ZeniteSolar/MT19/README.md

# MT19
Tachometer Module for CANBUS with ATmega328p
