ZeniteSolar/MT19/hardware/rj45.step

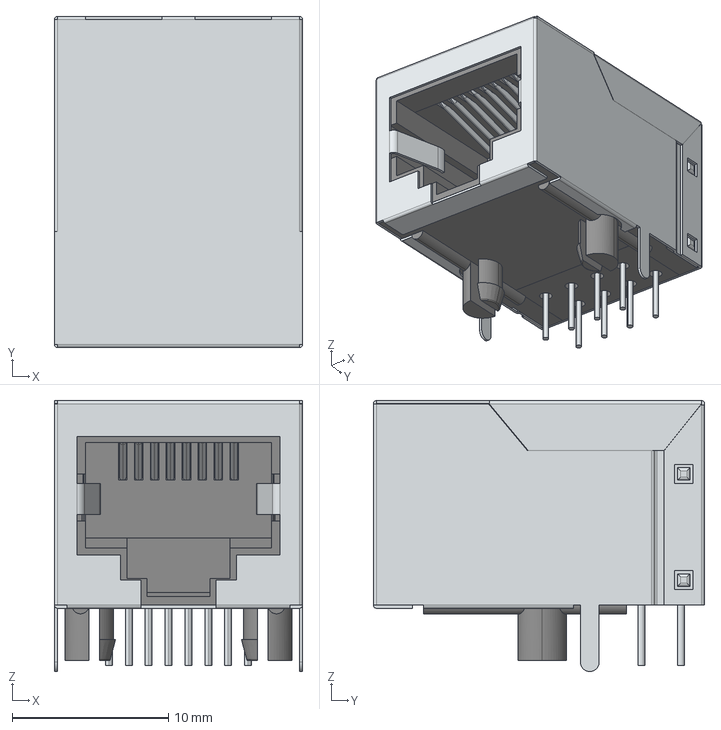
[picture p1: CAD file, 2019-05-07]
hardware/rj45.step
15.9 x 21.2 x 17.3 mm
