ZeniteSolar/MT19/hardware/PDF/basicsensormodule.pdf

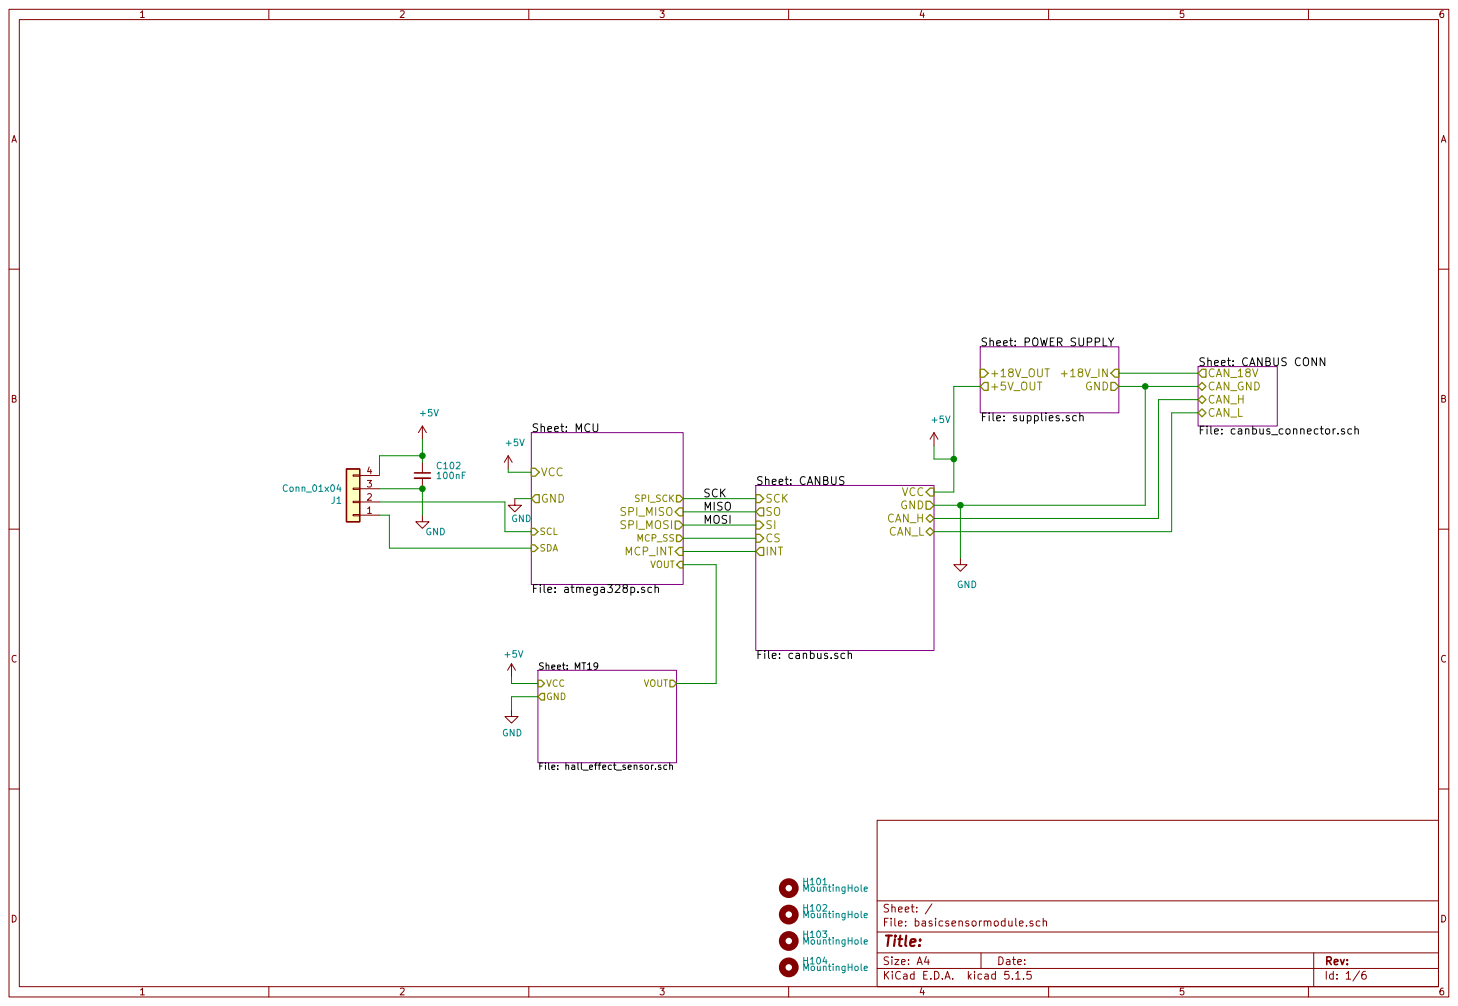
[picture p2: page 1]

Id: 1/6 Title: File: basicsensormodule.sch Sheet: / Sheet: MCU
+5VGND GND

1 | MISO

MOSI

Sheet: MT19 File: hall_effect_sensor.sch VCC GND

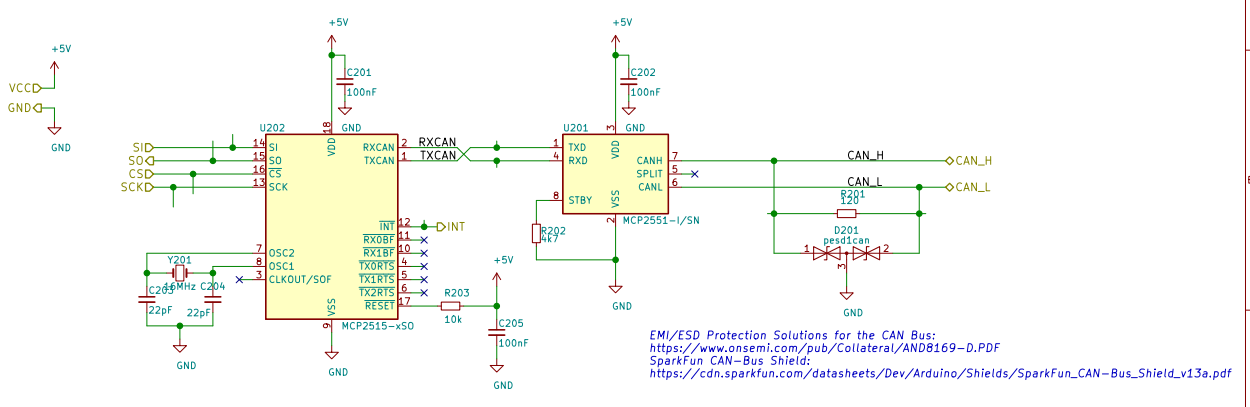
[picture p3: page 2]

3 RXD 4 SPLIT 5 CANL 6 CANH 7 STBY 8 U201 MCP2551-I/SN

Id: 2/6 Title: File: canbus.sch Sheet: /CANBUS/ C205

EMI/ESD Protection Solutions for the CAN Bus:
https://www.onsemi.com/pub/Collateral/AND8169-D.PDF
SparkFun CAN-Bus Shield:
https://cdn.sparkfun.com/datasheets/Dev/Arduino/Shields/SparkFun_CAN-Bus_Shield_v13a.pdf

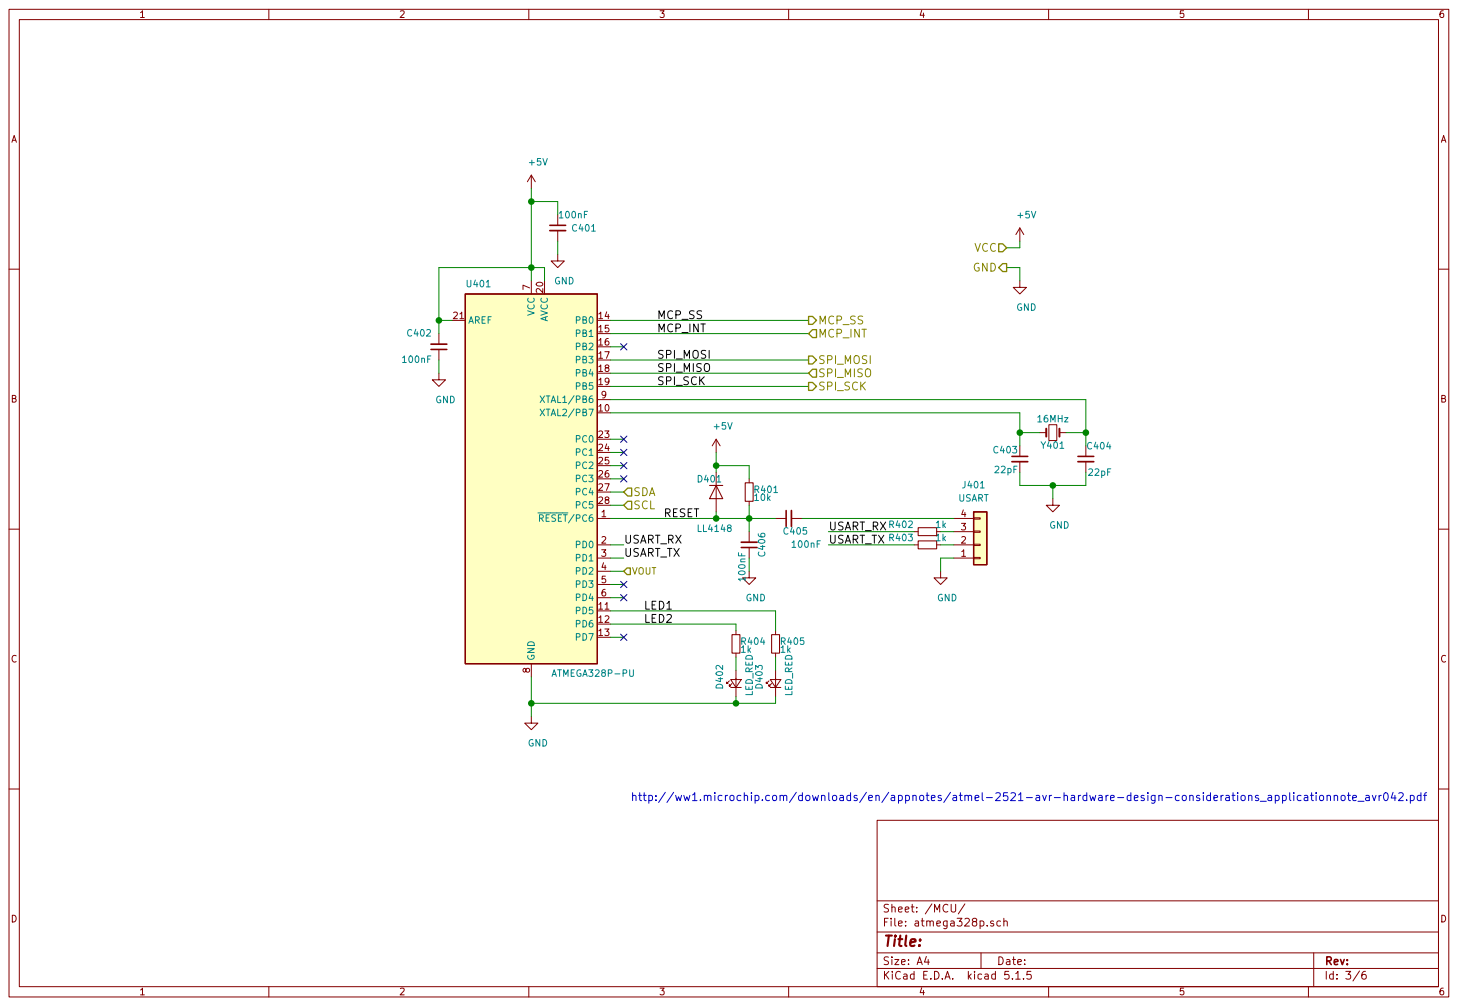
[picture p4: page 3]

http://ww1.microchip.com/downloads/en/appnotes/atmel-2521-avr-hardware-design-considerations_applicationnote_avr042.pdf

File: atmega328p.sch Sheet: /MCU/
Id: 3/6 Title:

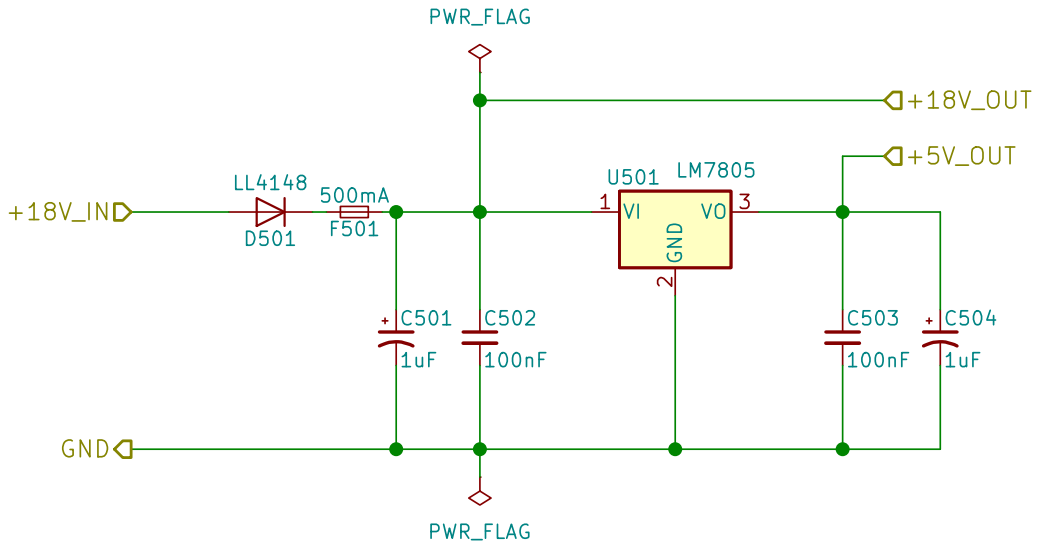
[picture p5: page 4]

File: supplies.sch Sheet: /POWER SUPPLY/ PWR_FLAG

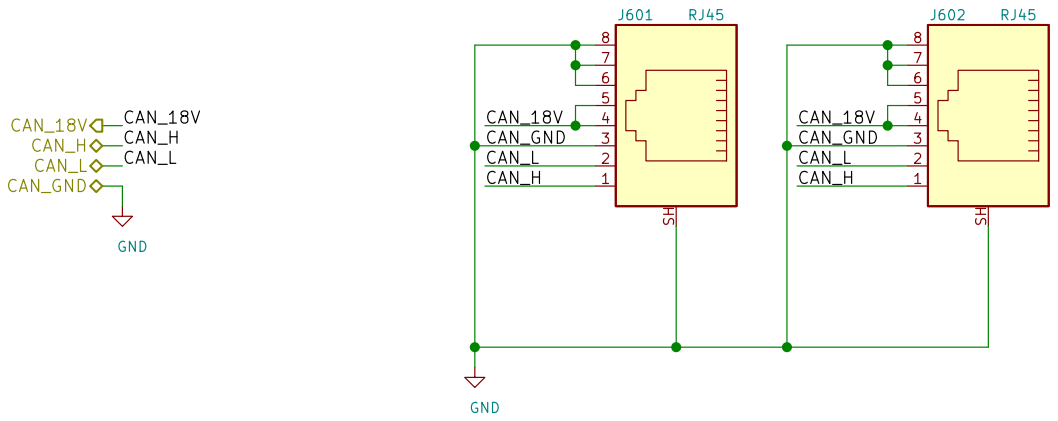
[picture p6: page 5]

File: canbus_connector.sch Sheet: /CANBUS CONN/ GND

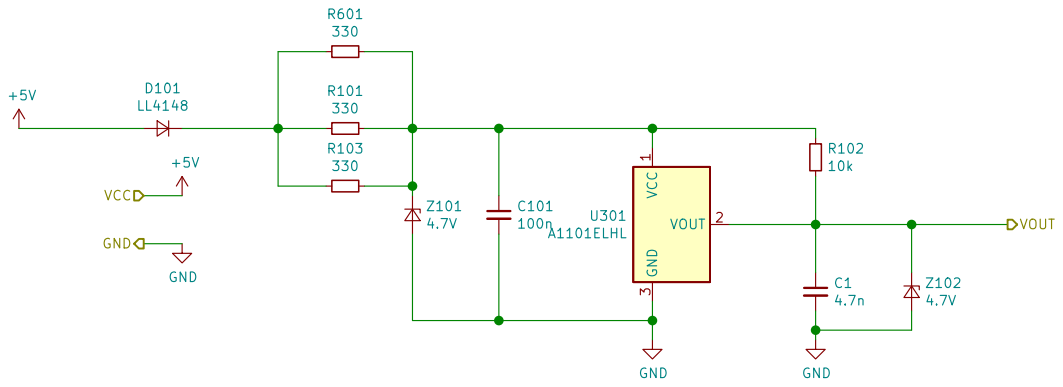
[picture p7: page 6]
