ZeniteSolar/MT19/hardware/PDF/basicsensormodule-B_Cu.pdf

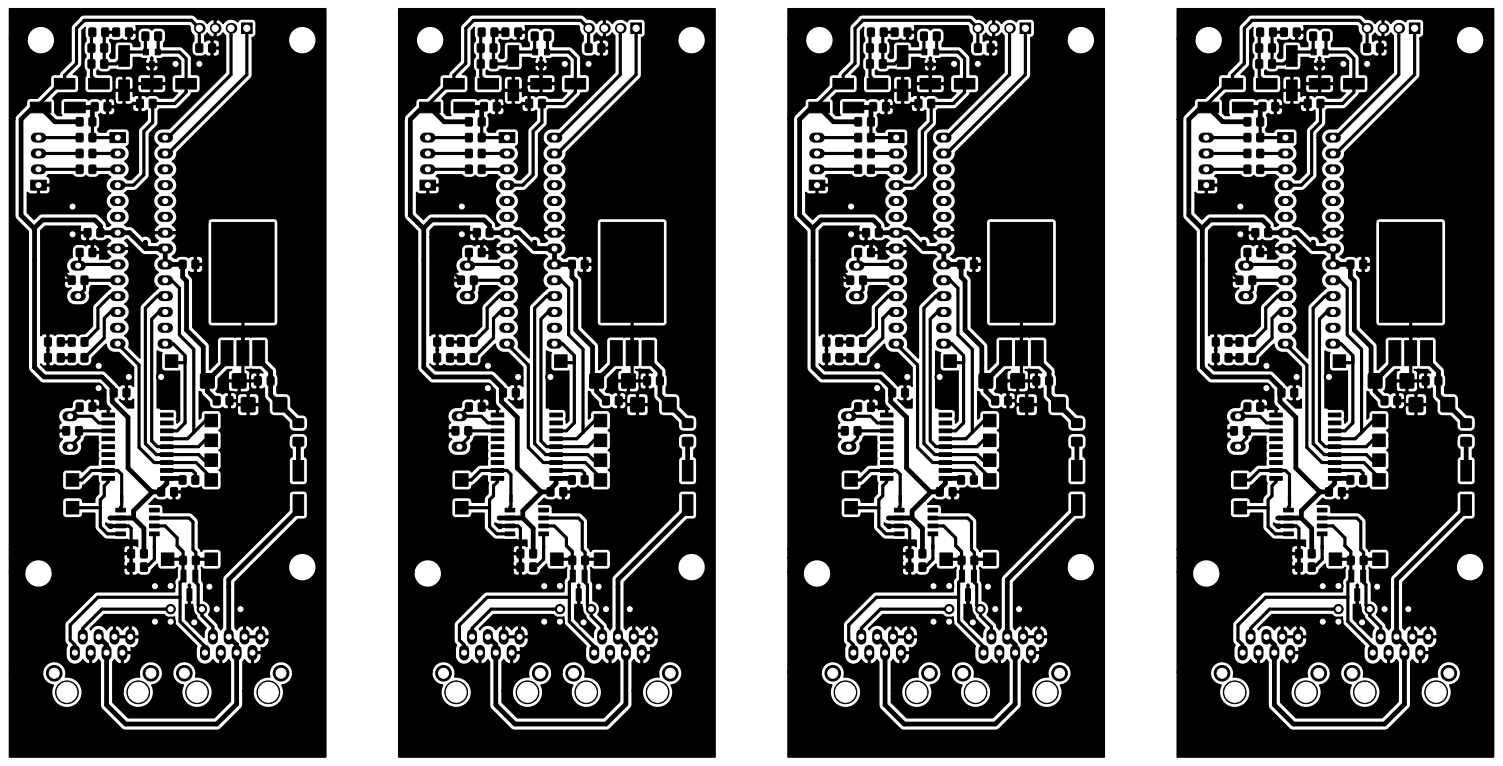
[picture p8: page 1]
