ZeniteSolar/MT19/hardware/basicsensormodule.kicad_pcb

## KiCad design hardware/basicsensormodule.kicad_pcb (2020-01-19)

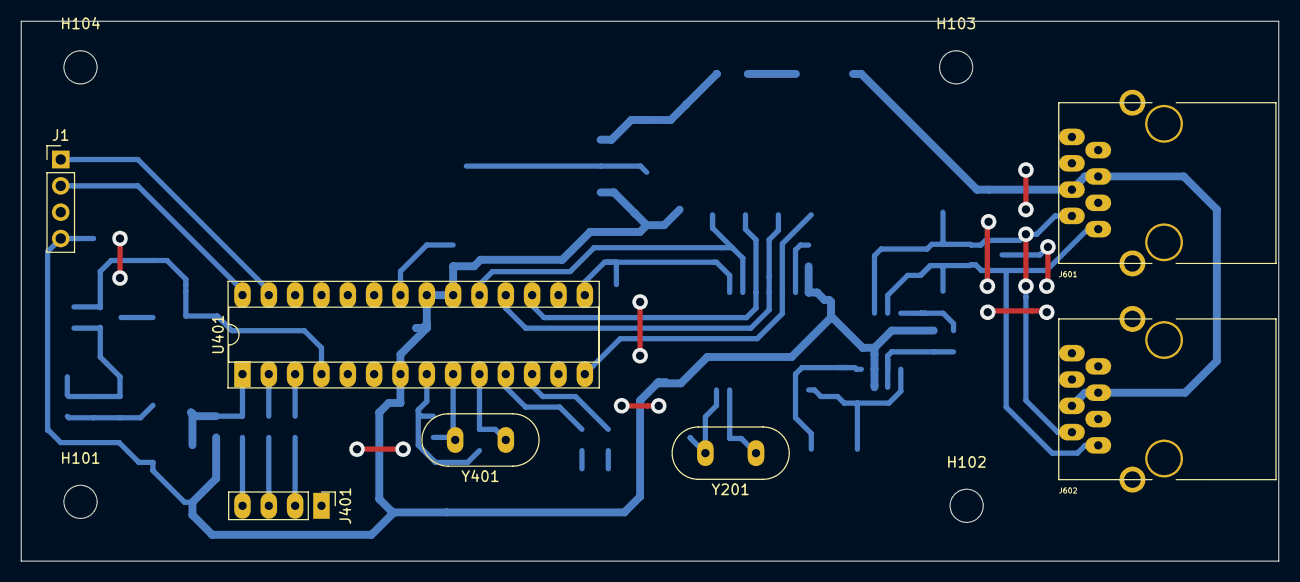
[picture p9: board basicsensormodule.kicad_pcb from above]

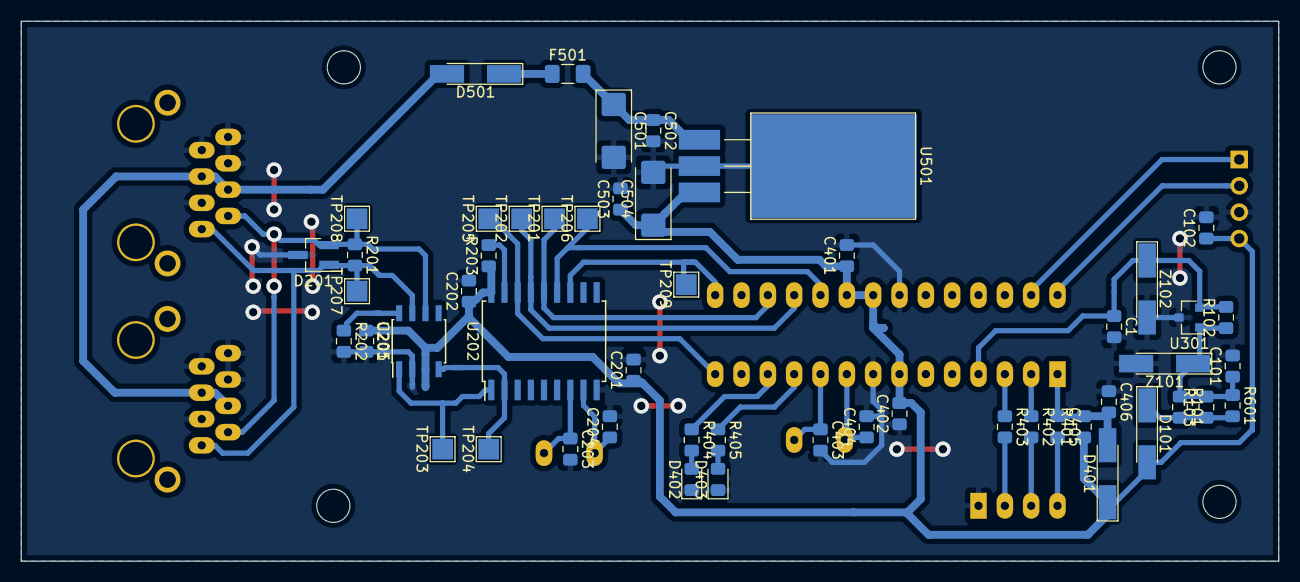
[picture p10: board basicsensormodule.kicad_pcb from below]

Board: 2 copper layers, 121.3 x 52.1 mm, 63 parts (52 on the bottom side), 35 nets.

Parts:
C1: 4.7n; C_0805_2012Metric_Pad1.15x1.40mm_HandSolder
C101: 100n; C_0805_2012Metric_Pad1.15x1.40mm_HandSolder
C102, C201, C202, C205, C401, C402, C405, C406, C502, C503: 100nF; C_0805_2012Metric_Pad1.15x1.40mm_HandSolder
C203, C204, C403, C404: 22pF; C_0805_2012Metric_Pad1.15x1.40mm_HandSolder
C501, C504: 1uF; CP_EIA-6032-20_AVX-F_Pad2.25x2.35mm_HandSolder
D101, D401, D501: LL4148; D_MiniMELF_Handsoldering
D201: pesd1can; SOT-23_Handsoldering
D402, D403: LED_RED; LED_0805_2012Metric_Pad1.15x1.40mm_HandSolder
F501: 500mA; Fuse_1206_3216Metric_Pad1.42x1.75mm_HandSolder
H101, H102, H103, H104: MountingHole; MountingHole_3.2mm_M3
J1: Conn_01x04; PinHeader_1x04_P2.54mm_Vertical
J401: USART; PinHeader_1x04_P2.54mm_Vertical
J601, J602: RJ45; RJ45_YH59_01
R101, R103, R601: 330; R_0805_2012Metric_Pad1.15x1.40mm_HandSolder
R102, R203, R401: 10k; R_0805_2012Metric_Pad1.15x1.40mm_HandSolder
R201: 120; R_0805_2012Metric_Pad1.15x1.40mm_HandSolder
R202: 4k7; R_0805_2012Metric_Pad1.15x1.40mm_HandSolder
R402, R403, R404, R405: 1k; R_0805_2012Metric_Pad1.15x1.40mm_HandSolder
TP201: SI; TestPoint_Pad_2.0x2.0mm
TP202: SO; TestPoint_Pad_2.0x2.0mm
TP203: TXCAN; TestPoint_Pad_2.0x2.0mm
TP204: RXCAN; TestPoint_Pad_2.0x2.0mm
TP205: SC; TestPoint_Pad_2.0x2.0mm
TP206: SCK; TestPoint_Pad_2.0x2.0mm
TP207: CAN_H; TestPoint_Pad_2.0x2.0mm
TP208: CAN_L; TestPoint_Pad_2.0x2.0mm
TP209: INT; TestPoint_Pad_2.0x2.0mm
U201: MCP2551-I/SN; SOIC-8_3.9x4.9mm_P1.27mm
U202: MCP2515-xSO; SOIC-18W_7.5x11.6mm_P1.27mm
U301: A1101ELHL; SOT-23
U401: ATMEGA328P-PU; DIP-28_W7.62mm_Socket
U501: LM7805; TO-220-3_Horizontal_TabDown_SMD
Y201, Y401: 16MHz; Crystal_HC49-U_Vertical
Z101, Z102: 4.7V; D_MiniMELF_Handsoldering

Connections:
+5V: C102.1, C201.1, C202.1, C205.1, C401.1, C402.2, C503.1, C504.1, D101.2, D401.1, J1.4, R203.1, R401.1, U201.3, U202.18, U401.7, U401.20, U401.21, U501.3
/CANBUS CONN/CAN_H: D201.1, J601.1, J602.1, R201.2, TP207.1, U201.7
/CANBUS CONN/CAN_L: D201.2, J601.2, J602.2, R201.1, TP208.1, U201.6
/CANBUS/CS: TP205.1, U202.16, U401.14
/CANBUS/INT: TP209.1, U202.12, U401.15
/CANBUS/RXCAN: TP204.1, U201.4, U202.2
/CANBUS/TXCAN: TP203.1, U201.1, U202.1
/MCU/LED1: R405.1, U401.11
/MCU/LED2: R404.1, U401.12
/MCU/RESET: C405.1, C406.2, D401.2, R401.2, U401.1
/MCU/SCL: J1.2, U401.28
/MCU/SDA: J1.1, U401.27
/MCU/USART_RX: R402.1, U401.2
/MCU/USART_TX: R403.1, U401.3
/MCU/VOUT: C1.1, R102.2, U301.2, U401.4, Z102.1
/MISO: TP202.1, U202.15, U401.18
/MOSI: TP201.1, U202.14, U401.17
/POWER SUPPLY/+18V_IN: D501.2, J601.4, J601.5, J602.4, J602.5
/POWER SUPPLY/+18V_OUT: C501.1, C502.1, F501.2, U501.1
/SCK: TP206.1, U202.13, U401.19
GND: C1.2, C101.2, C102.2, C201.2, C202.2, C203.2, C204.2, C205.2, C401.2, C402.1, C403.2, C404.2, C406.1, C501.2, C502.2, C503.2, C504.2, D201.3, D402.1, D403.1, J1.3, J401.1, J601.3, J601.6, J601.7, J601.8, J602.3, J602.6, J602.7, J602.8, R202.2, U201.2, U202.9, U301.3, U401.8, U401.22, U501.2, Z101.2, Z102.2
unnamed: C101.1, R101.1, R102.1, R103.2, R601.1, U301.1, Z101.1
unnamed: C203.1, U202.7, Y201.1
unnamed: C204.1, U202.8, Y201.2
unnamed: C403.1, U401.10, Y401.1
unnamed: C404.1, U401.9, Y401.2
unnamed: C405.2, J401.4
unnamed: D101.1, R101.2, R103.1, R601.2
unnamed: D402.2, R404.2
unnamed: D403.2, R405.2
unnamed: D501.1, F501.1
unnamed: J401.2, R403.2
unnamed: J401.3, R402.2
unnamed: R202.1, U201.8
unnamed: R203.2, U202.17
