ZeniteSolar/MT19/firmware/src/machine.h

/**
 * @file machine.h
 *
 * @defgroup MACHINE State Machine Module
 *
 * @brief Implements the main state machine of the system.
 *
 */

#ifndef MACHINE_H
#define MACHINE_H 

#include <avr/io.h>
#include <avr/wdt.h>
#include <avr/interrupt.h>

#include "conf.h"

// Equations for mode 2 (CTC with TOP OCR2A)
// Note the resolution. For example.. at 150hz, ICR1 = PWM_TOP = 159, so it
#define MACHINE_TIMER_TOP ((F_CPU/(2*MACHINE_TIMER_PRESCALER))/(MACHINE_TIMER_FREQUENCY) -1)

#ifdef ADC_ON
#include "adc.h"
#endif // ADC_ON
#ifdef USART_ON
#include "usart.h"
#endif //USART_ON
#include "dbg_vrb.h"
#ifdef CAN_ON
#include "can.h"
#include "can_app.h"
extern const uint8_t can_filter[];
#endif // CAN_ON

typedef enum state_machine{
    STATE_INITIALIZING,
    STATE_IDLE,
    STATE_RUNNING,
    STATE_ERROR,
    STATE_RESET,
} state_machine_t;

typedef union system_flags{
    struct{
        uint8_t     none          :1;
    };
    uint8_t   all;
} system_flags_t;

typedef union error_flags{
    struct{
        uint8_t     no_canbus     :1;
    };
    uint8_t   all;
}error_flags_t;

void tachometer_init(void);

typedef struct tachometer
{
    uint32_t overflow_counter;
    uint16_t dt_avg_sum_count;
    uint32_t dt_avg_sum;
    uint16_t rpm;
}tachometer_t;

// machine checks
//void check_buffers(void);
//void reset_measurements(void);

// debug functions
void print_configurations(void);
void print_system_flags(void);
void print_error_flags(void);

// machine tasks
void task_initializing(void);
void task_idle(void);
void task_running(void);
void task_error(void);
void task_reset(void);

// the machine itself
void set_machine_initial_state(void);
void machine_init(void);
void machine_run(void);
void set_state_error(void);
void set_state_initializing(void);
void set_state_idle(void);
void set_state_running(void);
void set_state_reset(void);

// tachometer functions
void can_app_send_rpm(void);
void compute_rpm_avg(void);

// ISRs
ISR(TIMER2_COMPA_vect);
ISR(PCINT2_vect);

#endif /* ifndef MACHINE_H */
