ZeniteSolar/MT19/firmware/src/can_app.h

/**
 * @file can_app.h
 *
 * @defgroup CANAPP    Application Module for canbus
 *
 * @brief The application layer module for canbus
 *
 */

#ifndef CAN_APP_H
#define CAN_APP_H 

#include "conf.h"
#include "dbg_vrb.h"
#include "../lib/bit_utils.h"
#include "can.h"
#include "can_ids.h"
#include "machine.h"
#include "usart.h"

void can_app_print_msg(can_t *msg);
void can_app_task(void);
void can_app_send_state(void);
void can_app_send_rpm(void);

void check_can(void);

#ifdef CAN_ON
#define CAN_APP_SEND_STATE_CLK_DIV  CAN_APP_SEND_STATE_FREQ
#define CAN_APP_SEND_RPM_CLK_DIV    CAN_APP_SEND_RPM_FREQ
#else
#define CAN_APP_SEND_STATE_CLK_DIV  1
#define CAN_APP_SEND_RPM_CLK_DIV    1
#endif

#endif /* ifndef CAN_APP_H */
