ZeniteSolar/MT19/(commit log)

2019-05-07 Arquivos iniciados do repositório MVC19
    [analog.sch, atmega328p.sch, basicsensormodule.kicad_pcb, basicsensormodule.sch, canbus.sch, canbus_connector.sch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]
2019-05-09 Layout MT19 criado para o Taquímetro do barco.
    [atmega328p.sch, basicsensormodule.kicad_pcb, basicsensormodule.sch, canbus.sch, canbus_connector.sch, hall_effect_sensor.sch, supplies.sch]
2019-05-09 Atualização MT19
    [basicsensormodule-B.Cu.gbr, basicsensormodule-B_Cu.gbr, basicsensormodule.drl]
2019-05-24 layout finalizado
    [basicsensormodule.kicad_pcb, hall_effect_sensor.sch]
2019-08-08 atualizei o hardware
    [basicsensormodule.kicad_pcb, basicsensormodule.sch]
2020-01-19 3D exported
    [basicsensormodule.kicad_pcb, panel.kicad_pcb]
2021-12-15 Fix rpm calculation and timer prescaler
    [can_app.c, can_app.h, machine.c, machine.h]
2021-12-15 Use extern modifier to fix duplicated variables being defined on newer GCC
    [can_app.c, can_app.h, machine.c, machine.h]
2021-12-17 Change CAN CS pin because the previous one was PCINT0(Timer trigger interruption)
2021-12-17 Fix 0rpm and more small fixes
    [can_app.c, machine.c, machine.h]
2024-07-13 Update schematics, add BOM
    [atmega328p.kicad_sch, basicsensormodule.csv, basicsensormodule.kicad_sch, canbus.kicad_sch, canbus_connector.kicad_sch, hall_effect_sensor.kicad_sch, supplies.kicad_sch]
